youngdaniel345/ay19_agv_NetGrokII/README.md

#NetGrok II 

This branch contains our AGV project code.

Members: Joshua Balba Matthew Kim Tyler Reece Daniel Young

Instructor: LTC Harvie

Advisor: Kyle King
